AntonSangho/picobreadboard_PCB/Picobreadboad_PCB.kicad_pcb

## KiCad design Picobreadboad_PCB.kicad_pcb (2024-06-24)

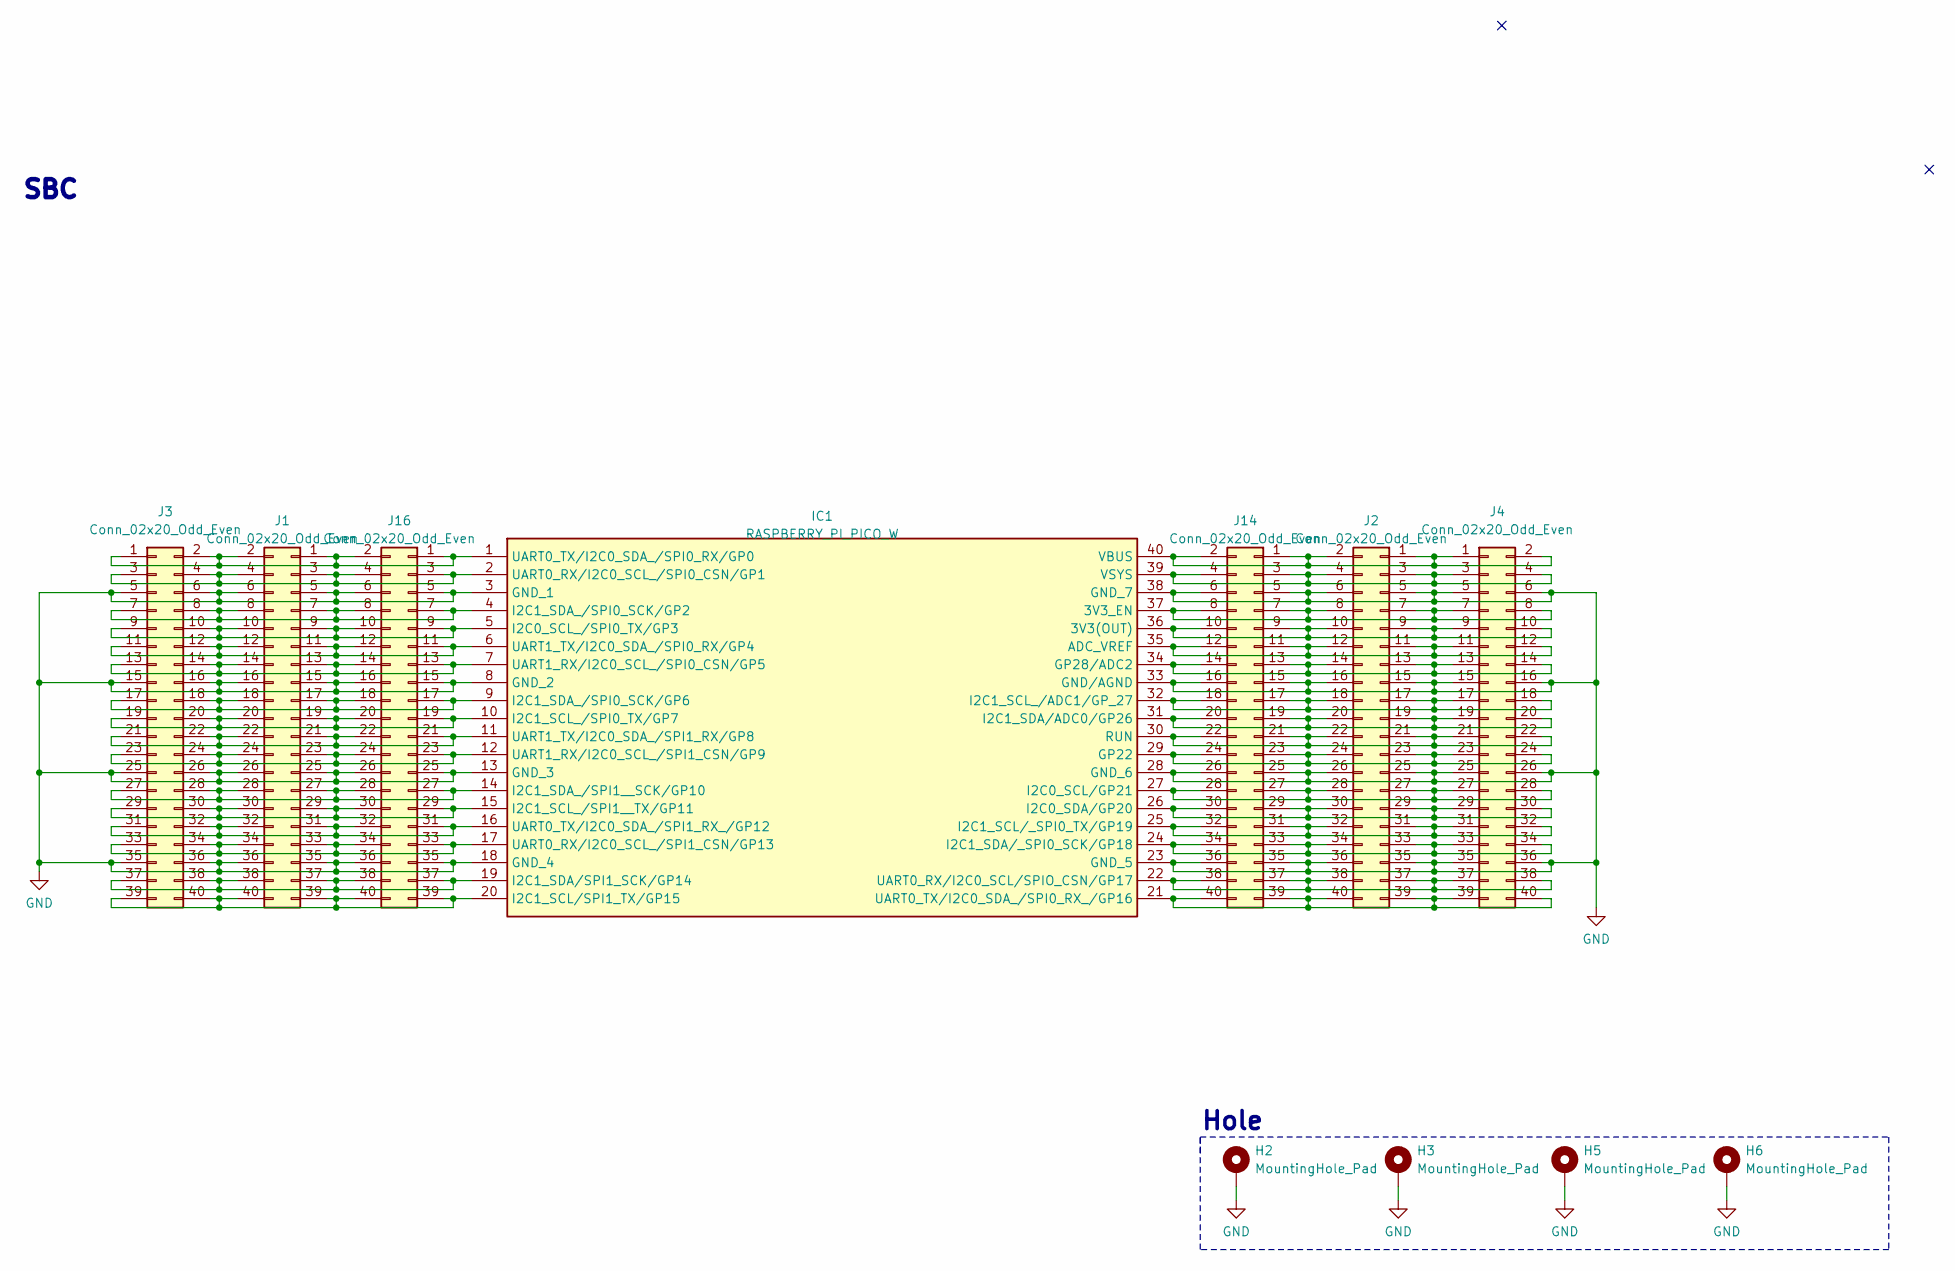
[picture p1: schematic Picobreadboad_PCB.kicad_sch, PicoBreadBoad]

Parts:
H2, H3, H5, H6: MountingHole_Pad; MountingHole_2.7mm_M2.5_ISO7380_Pad_TopOnly
IC1: RASPBERRY_PI_PICO_W; RASPBERRYPIPICOW; Manufacturer_Part_Number RASPBERRY PI PICO W
J1, J2, J14: Conn_02x20_Odd_Even; PinSocket_2x20_P2.54mm_Vertical_SMD; Mfr. Part # PM254-2-20-S-8.5; LCSC Part # C3975165
J3, J4: Conn_02x20_Odd_Even; PinHeader_2x20_P2.54mm_Vertical_SMD; Mfr. Part # HB-PH9-254220PB2GOP; LCSC Part # C6332245
J16: Conn_02x20_Odd_Even; PinSocket_2x20_P2.54mm_Vertical_SMD; LCSC Part # C3975165

Connections:
GND: H2.1, H3.1, H5.1, H6.1, IC1.3 (GND_1), IC1.8 (GND_2), IC1.13 (GND_3), IC1.18 (GND_4), IC1.23 (GND_5), IC1.28 (GND_6), IC1.33 (GND/AGND), IC1.38 (GND_7), J1.5, J1.6, J1.15, J1.16, J1.25, J1.26, J1.35, J1.36, J2.5, J2.6, J2.15, J2.16, J2.25, J2.26, J2.35, J2.36, J3.5, J3.6, J3.15, J3.16, J3.25, J3.26, J3.35, J3.36, J4.5, J4.6, J4.15, J4.16, J4.25, J4.26, J4.35, J4.36, J14.5, J14.6, J14.15, J14.16, J14.25, J14.26, J14.35, J14.36, J16.5, J16.6, J16.15, J16.16, J16.25, J16.26, J16.35, J16.36
unnamed: IC1.1 (UART0_TX/I2C0_SDA_/SPI0_RX/GP0), J1.1, J1.2, J3.1, J3.2, J16.1, J16.2
unnamed: IC1.2 (UART0_RX/I2C0_SCL_/SPI0_CSN/GP1), J1.3, J1.4, J3.3, J3.4, J16.3, J16.4
unnamed: IC1.4 (I2C1_SDA_/SPI0_SCK/GP2), J1.7, J1.8, J3.7, J3.8, J16.7, J16.8
unnamed: IC1.5 (I2C0_SCL_/SPI0_TX/GP3), J1.9, J1.10, J3.9, J3.10, J16.9, J16.10
unnamed: IC1.6 (UART1_TX/I2C0_SDA_/SPI0_RX/GP4), J1.11, J1.12, J3.11, J3.12, J16.11, J16.12
unnamed: IC1.7 (UART1_RX/I2C0_SCL_/SPI0_CSN/GP5), J1.13, J1.14, J3.13, J3.14, J16.13, J16.14
unnamed: IC1.9 (I2C1_SDA_/SPI0_SCK/GP6), J1.17, J1.18, J3.17, J3.18, J16.17, J16.18
unnamed: IC1.10 (I2C1_SCL_/SPI0_TX/GP7), J1.19, J1.20, J3.19, J3.20, J16.19, J16.20
unnamed: IC1.11 (UART1_TX/I2C0_SDA_/SPI1_RX/GP8), J1.21, J1.22, J3.21, J3.22, J16.21, J16.22
unnamed: IC1.12 (UART1_RX/I2C0_SCL_/SPI1_CSN/GP9), J1.23, J1.24, J3.23, J3.24, J16.23, J16.24
unnamed: IC1.14 (I2C1_SDA_/SPI1__SCK/GP10), J1.27, J1.28, J3.27, J3.28, J16.27, J16.28
unnamed: IC1.15 (I2C1_SCL_/SPI1__TX/GP11), J1.29, J1.30, J3.29, J3.30, J16.29, J16.30
unnamed: IC1.16 (UART0_TX/I2C0_SDA_/SPI1_RX_/GP12), J1.31, J1.32, J3.31, J3.32, J16.31, J16.32
unnamed: IC1.17 (UART0_RX/I2C0_SCL_/SPI1_CSN/GP13), J1.33, J1.34, J3.33, J3.34, J16.33, J16.34
unnamed: IC1.19 (I2C1_SDA/SPI1_SCK/GP14), J1.37, J1.38, J3.37, J3.38, J16.37, J16.38
unnamed: IC1.20 (I2C1_SCL/SPI1_TX/GP15), J1.39, J1.40, J3.39, J3.40, J16.39, J16.40
unnamed: IC1.40 (VBUS), J2.1, J2.2, J4.1, J4.2, J14.1, J14.2
unnamed: IC1.39 (VSYS), J2.3, J2.4, J4.3, J4.4, J14.3, J14.4
unnamed: IC1.37 (3V3_EN), J2.7, J2.8, J4.7, J4.8, J14.7, J14.8
unnamed: IC1.36 (3V3(OUT)), J2.9, J2.10, J4.9, J4.10, J14.9, J14.10
unnamed: IC1.35 (ADC_VREF), J2.11, J2.12, J4.11, J4.12, J14.11, J14.12
unnamed: IC1.34 (GP28/ADC2), J2.13, J2.14, J4.13, J4.14, J14.13, J14.14
unnamed: IC1.32 (I2C1_SCL_/ADC1/GP_27), J2.17, J2.18, J4.17, J4.18, J14.17, J14.18
unnamed: IC1.31 (I2C1_SDA/ADC0/GP26), J2.19, J2.20, J4.19, J4.20, J14.19, J14.20
unnamed: IC1.30 (RUN), J2.21, J2.22, J4.21, J4.22, J14.21, J14.22
unnamed: IC1.29 (GP22), J2.23, J2.24, J4.23, J4.24, J14.23, J14.24
unnamed: IC1.27 (I2C0_SCL/GP21), J2.27, J2.28, J4.27, J4.28, J14.27, J14.28
unnamed: IC1.26 (I2C0_SDA/GP20), J2.29, J2.30, J4.29, J4.30, J14.29, J14.30
unnamed: IC1.25 (I2C1_SCL/_SPI0_TX/GP19), J2.31, J2.32, J4.31, J4.32, J14.31, J14.32
unnamed: IC1.24 (I2C1_SDA/_SPI0_SCK/GP18), J2.33, J2.34, J4.33, J4.34, J14.33, J14.34
unnamed: IC1.22 (UART0_RX/I2C0_SCL/SPIO_CSN/GP17), J2.37, J2.38, J4.37, J4.38, J14.37, J14.38
unnamed: IC1.21 (UART0_TX/I2C0_SDA_/SPI0_RX_/GP16), J2.39, J2.40, J4.39, J4.40, J14.39, J14.40

Notes on the sheet:
Hole
SBC

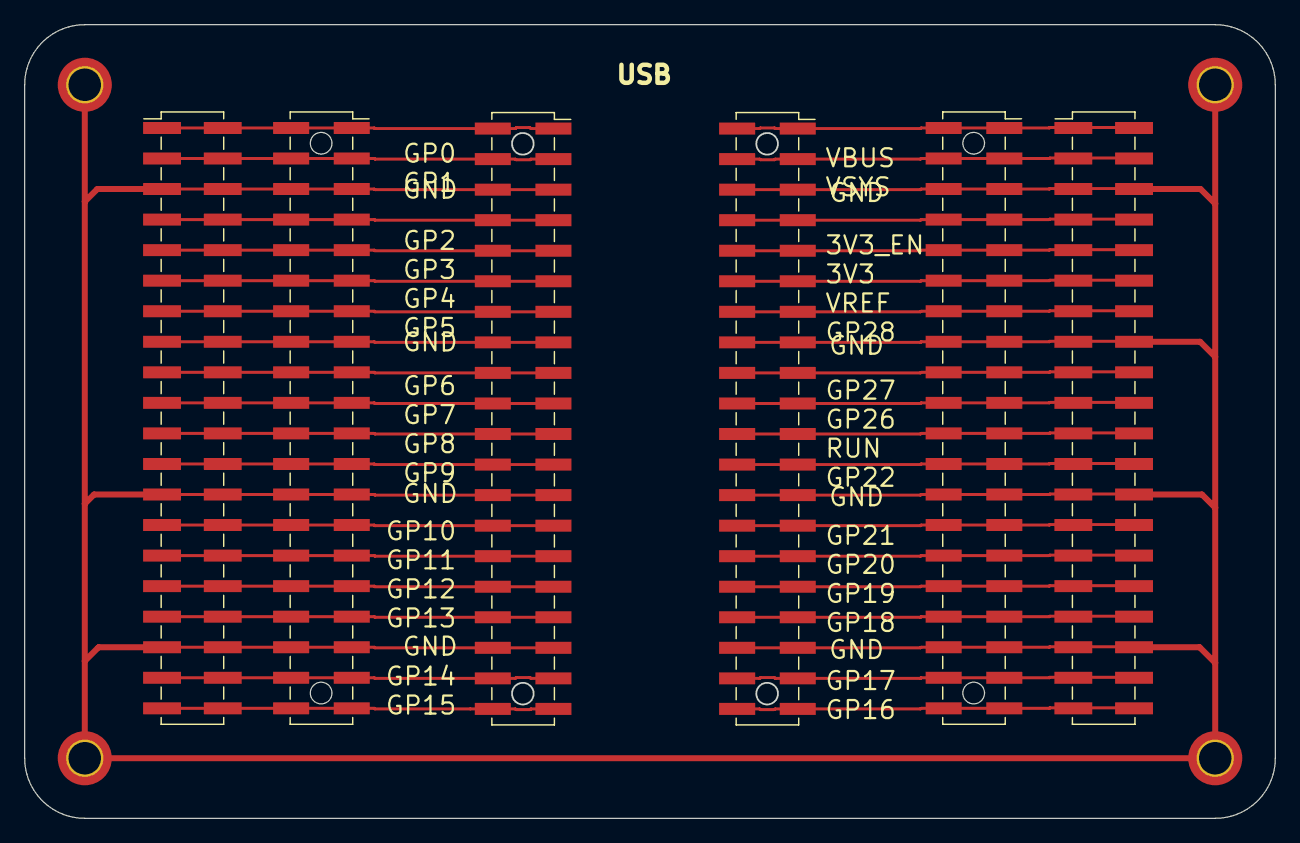
[picture p2: board Picobreadboad_PCB.kicad_pcb from above]

Board: 2 copper layers, 104.0 x 66.0 mm, 10 parts (0 on the bottom side), 33 nets.
